mcmilnick/power_control/coffee_pot_app/pic/add_buttons.png

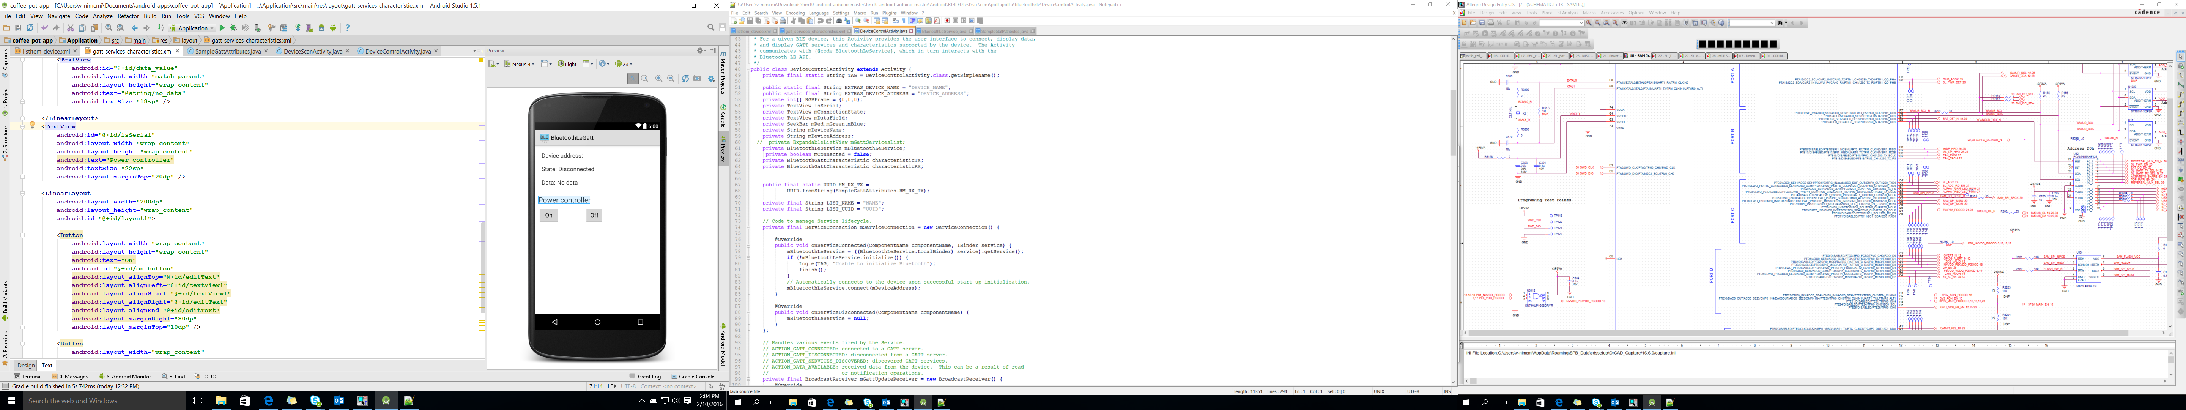
coffee_pot_app/pic/add_buttons.png
