mcmilnick/power_control/coffee_pot_app/pic/configure_attributes.png

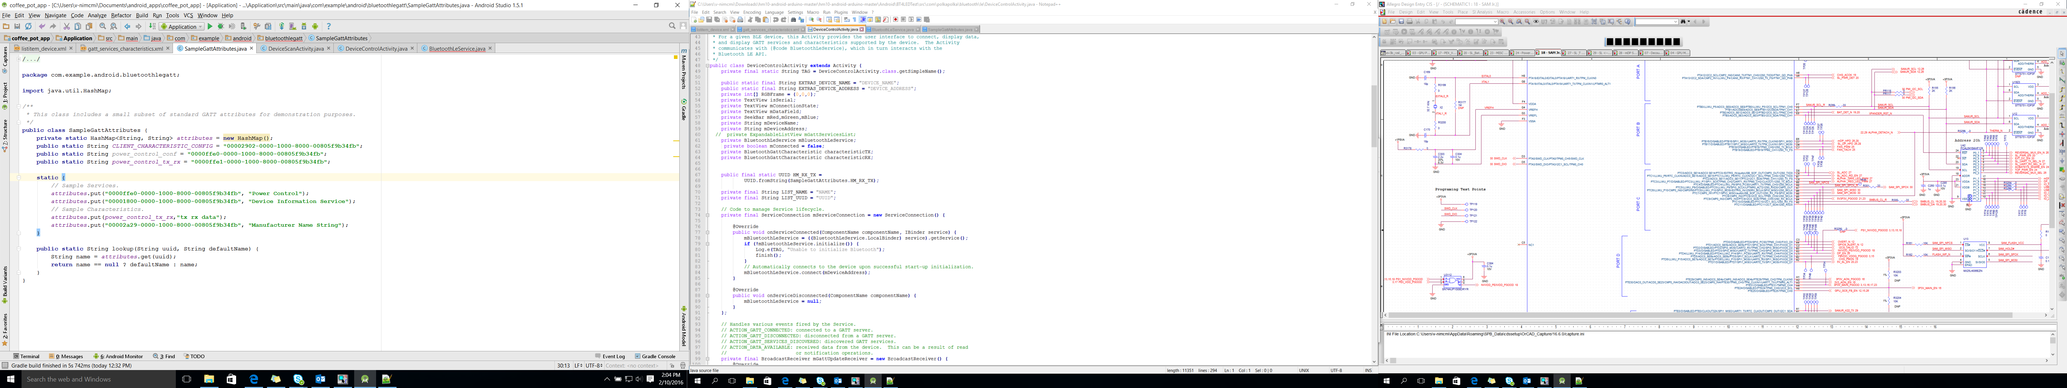
coffee_pot_app/pic/configure_attributes.png
