mcmilnick/power_control/coffee_pot_app/pic/edit layout.png

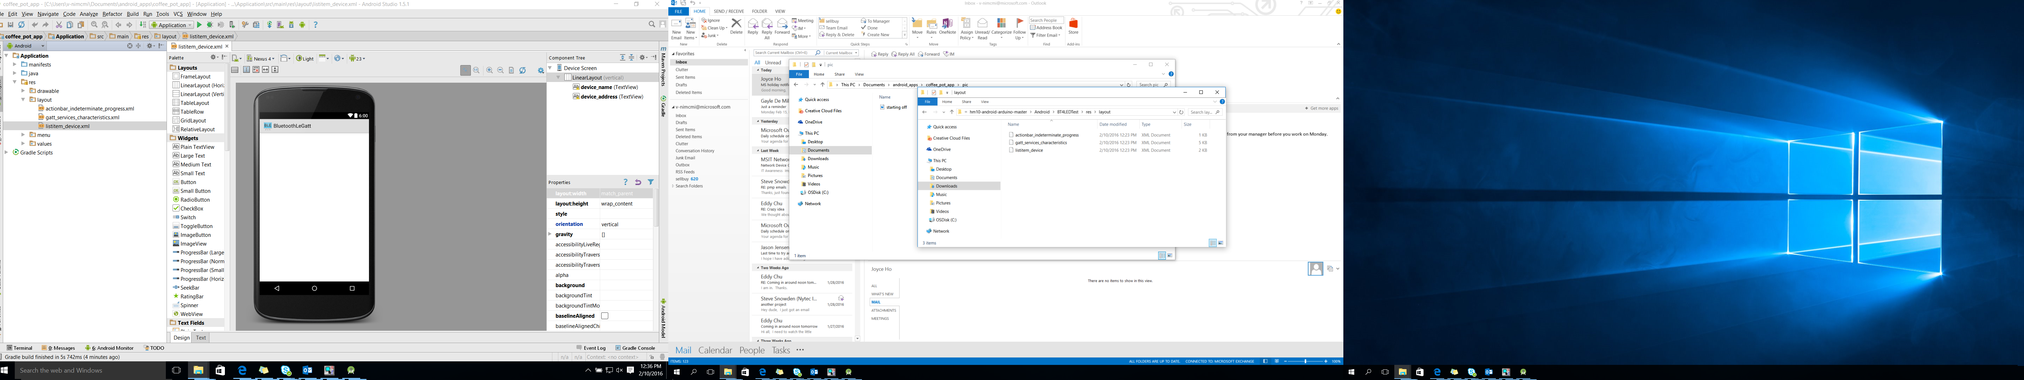
coffee_pot_app/pic/edit layout.png
