mcmilnick/power_control/coffee_pot_app/pic/read_and_write_commands.png

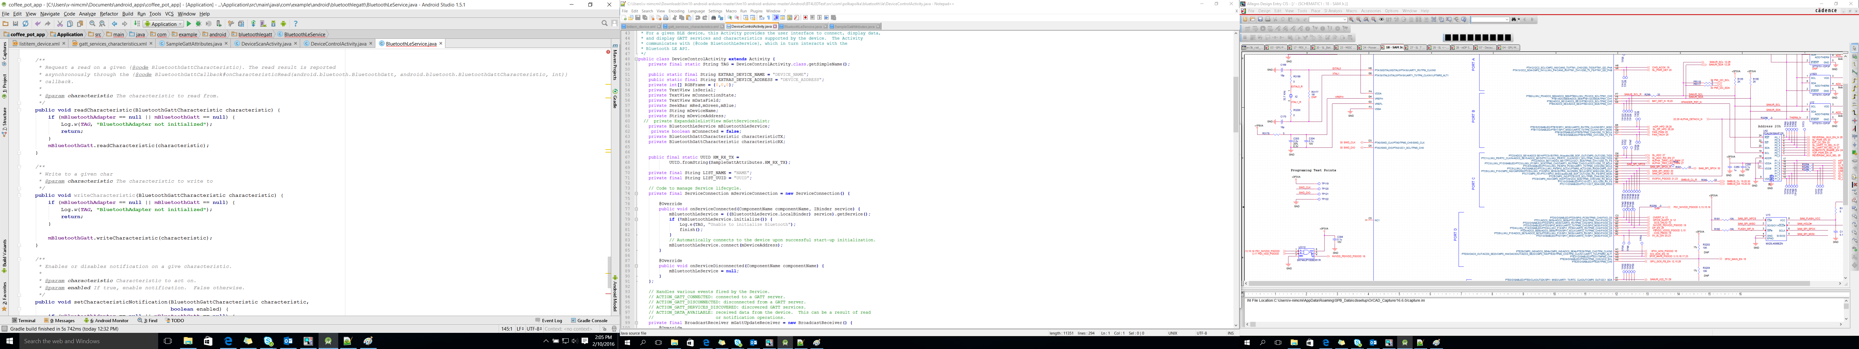
coffee_pot_app/pic/read_and_write_commands.png
