mcmilnick/power_control/coffee_pot_app/pic/starting off.png

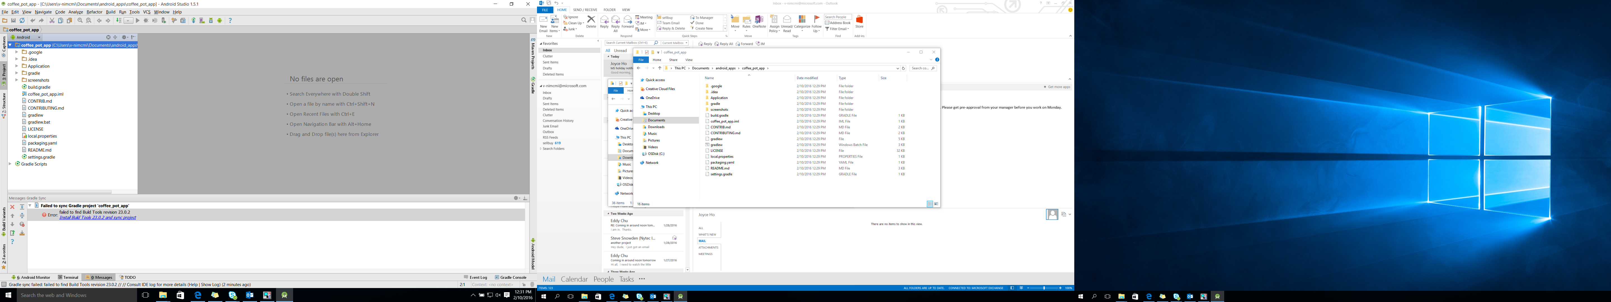
coffee_pot_app/pic/starting off.png
