mcmilnick/power_control/power_control_rev2_bom.xls

 |  |  | XPP Rev3 BOM
Part | Value | Quantity | Specs | Manufacturer# | Distributor# | Company | Notes
C3,5,6,7,17,18 | .1uF | 6 | 0.1UF 16V 10% X5R 0402 | GRM155R61C104KA88D | 490-5415-1-ND | Murata
C1,2,4,8,9,11,15,16 | 1.0uF | 8 | CAP CER 1UF 6.3V X5R 0402 | GRM155R60J105KE19D | 490-1320-1-ND | Murata
C13 | 0.2pF | 1 | CAP CER 0.2PF 50V NP0 0603 | CL10C0R2BB8NNNC | 1276-2144-1-ND | Samsung
C14 | 1.5pF | 1 | CAP CER 1.5PF 50V NP0 0603 | CL10C1R5BB8NNNC | 1276-1071-1-ND | Samsung
R1,2 | 560 | 2 | RES SMD 560 OHM 1% 1/10W 0603 | RC0603FR-07560RL | 311-560HRCT-ND | Yageo
R3 | 1.5k | 1 | RES 1.5K OHM 1/4W 5% CARBON FILM | CF14JT1K50 | CF14JT1K50CT-ND | Stackpole
D1 | 6.2V Zener | 1 | DIODE ZENER 6.2V 500MW DO35 | 1N821 | 1N821-1-ND | Microsemi
L1,2 | Fixed Inductor | 2 | .0018uH 5% .05ohm Unsheilded SMT | 1210-018J | 807-1210-018J | API | Change to 1210 next rev
U1 | Micro | 1 | PSOC BLE M0/Radio | CY8C4247LQI-BL473 | 428-3365-5-ND | Cypress
U2 | 24MHz crystal | 1 | Crystal 26.0000MHz 10ppm 6pF 80 Ohm | CX3225SB24000D0FFJCC | 1253-1352-1-ND | AVX
U3 | Programming header | 1 | 5pin JTAG Connector | TSW-105-07-T-S | SAM1035-05-ND | Samtec
U4 | Ceramic_Antenna | 1 | ANTENNA CHIP 2.4GHZ | 2450AT42B100E | 712-1008-1-ND | Johanson Tech
U5 | Red LED | 1 | LED 0402 RED 50MW 20MA SMD | SML-P11UTT86 | 511-1653-1-ND | Rohm
U6 | Green LED | 1 | LED 0402 GREEN 54MW 20MA SMD | SML-P11MTT86 | 511-1652-1-ND | Rohm
U7 | 5V Relay | 1 | SPDT 2A 5V Relay | G6E-134P-US DC5 | Z3668-ND | Omron
T1 | NPN Fet | 1 | TRANS NPN 30V 0.8A TO-18 | 2N2222 | 2N2222CS-ND | Central Semi
Con 1-6 | Test clips | 6 | Through hole hooks for testing | Keystone Electronics 5006 | 36-5006-ND | Keystone Electronics
