mcmilnick/power_control/mechanical/proto_coffee_box.stl

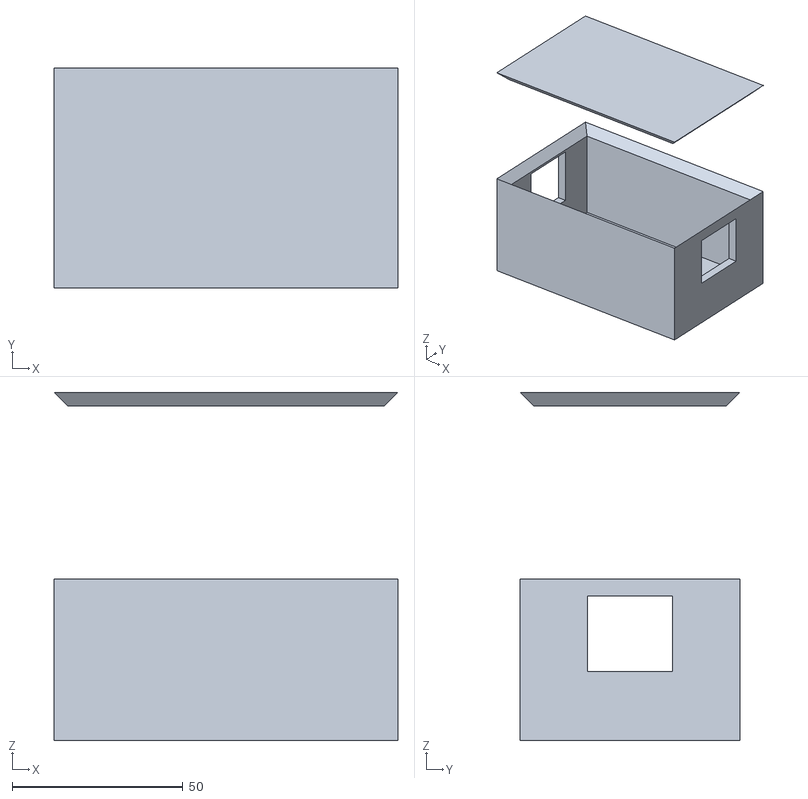
[picture p6: CAD file, 2016-02-23]
mechanical/proto_coffee_box.stl
100.7 x 64.3 x 102.0
