mcmilnick/power_control/(list of files, cad)

Other CAD files:
mechanical/general_box.blend
mechanical/proto_coffee_box.blend
