mcmilnick/power_control/power_control_rev2/power_control_rev2.brd

## EAGLE design power_control_rev2/power_control_rev2.brd (2016-03-08)

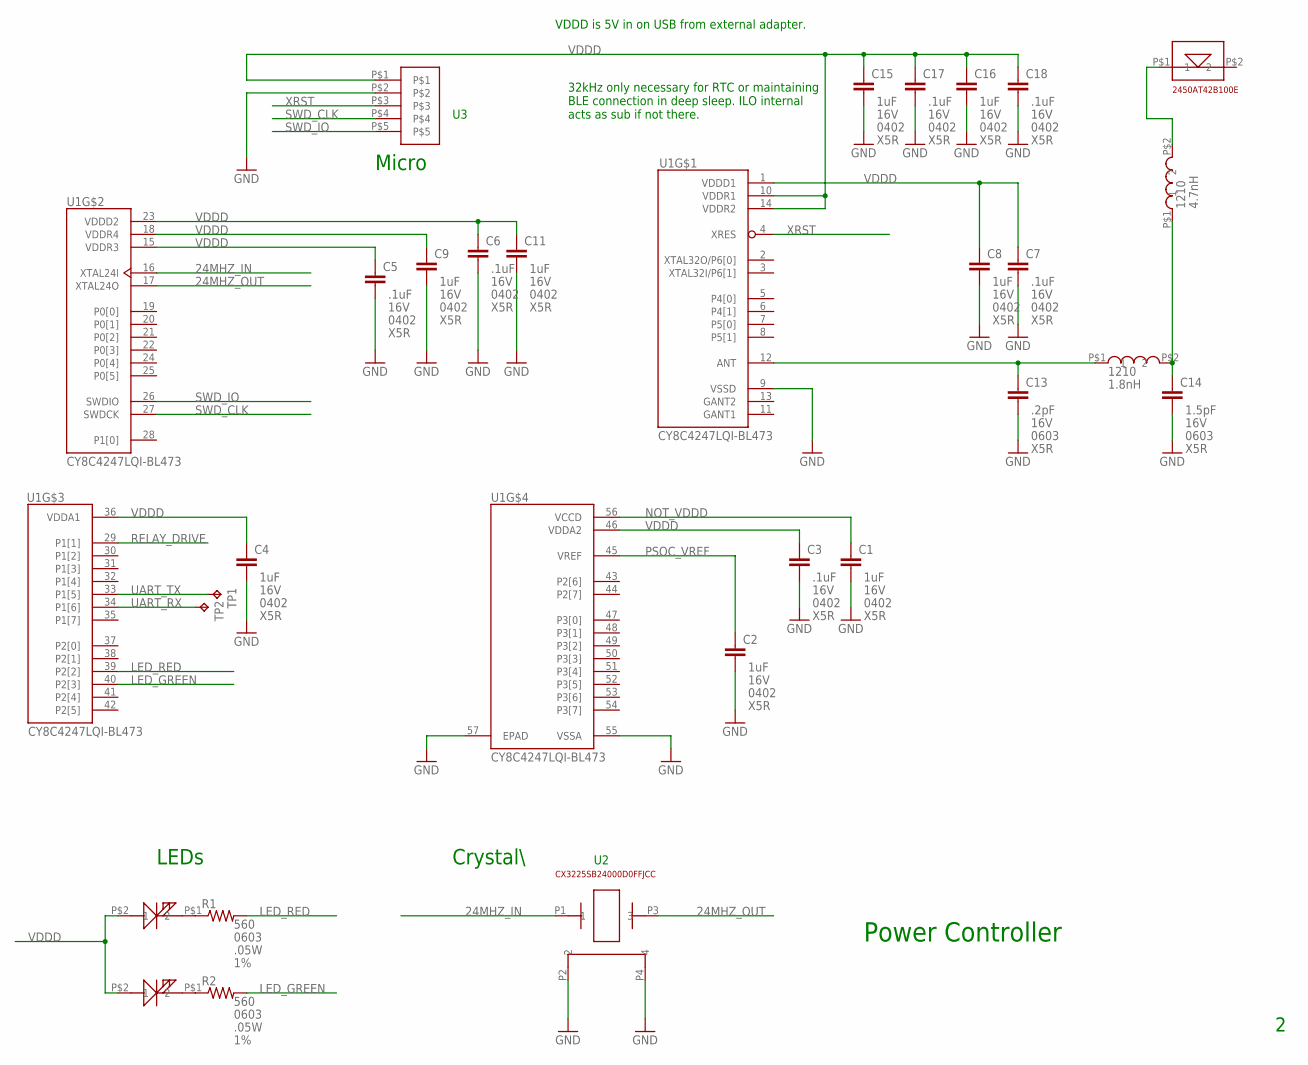
[picture p7: schematic power_control_rev2.sch, sheet 1]

Parts:
C1, C2, C3, C4, C5, C6, C7, C8, C9, C11, C15, C16, C17, C18: CC0402; C0402; RATING X5R; TOLERANCE 16V
C13, C14: CC0603; C0603
R1, R2: R-US_R0603; R0603; TOLERANCE 1%
TP1, TP2: TPB1,27; B1,27
U1: CY8C4247LQI-BL473; JEDEC_MO-248_QFN-56-7MMX7MM
U$1, U$8: 1210_INDUCTOR
U$2: CX3225SB24000D0FFJCC
U$3: SAMTEC1X5; 5XHEADER
U$4: 2450AT42B100E
U$5, U$6: SML-P11UTT86

Connections:
24MHZ_IN: U1.16 (XTAL24I), U$2.P1 (1)
24MHZ_OUT: U1.17 (XTAL24O), U$2.P3 (3)
GANT1: U1.11 (GANT1)
GANT2: U1.13 (GANT2)
GND: C1.2, C2.2, C3.2, C4.2, C5.2, C6.2, C7.2, C8.2, C9.2, C11.2, C13.2, C14.2, C15.2, C16.2, C17.2, C18.2, U1.9 (VSSD), U1.55 (VSSA), U1.57 (EPAD), U$2.P2 (2), U$2.P4 (4), U$3.P$2; also elsewhere on the board
LED_GREEN: R2.2, U1.40 (P2[3])
LED_RED: R1.2, U1.39 (P2[2])
unnamed: R2.1, U$6.P$1 (2)
unnamed: R1.1, U$5.P$1 (2)
unnamed: U$4.P$1 (1), U$8.P$2 (2)
unnamed: C13.1, U1.12 (ANT), U$1.P$1 (1)
unnamed: C14.1, U$1.P$2 (2), U$8.P$1 (1)
NOT_VDDD: C1.1, U1.56 (VCCD)
PSOC_VREF: C2.1, U1.45 (VREF)
RELAY_DRIVE: U1.29 (P1[1]); also elsewhere on the board
SWD_CLK: U1.27 (SWDCK), U$3.P$4
SWD_IO: U1.26 (SWDIO), U$3.P$5
UART_RX: TP2.TP, U1.34 (P1[6])
UART_TX: TP1.TP, U1.33 (P1[5])
VDDD: C3.1, C4.1, C5.1, C6.1, C7.1, C8.1, C9.1, C11.1, C15.1, C16.1, C17.1, C18.1, U1.1 (VDDD1), U1.10 (VDDR1), U1.14 (VDDR2), U1.15 (VDDR3), U1.18 (VDDR4), U1.23 (VDDD2), U1.36 (VDDA1), U1.46 (VDDA2), U$3.P$1, U$5.P$2 (1), U$6.P$2 (1); also elsewhere on the board
XRST: U1.4 (XRES), U$3.P$3

Notes on the sheet:
LEDs
Power Controller
Micro
32kHz only necessary for RTC or maintaining BLE connection in deep sleep. ILO internal acts as sub if not there.
Crystal\
VDDD is 5V in on USB from external adapter.

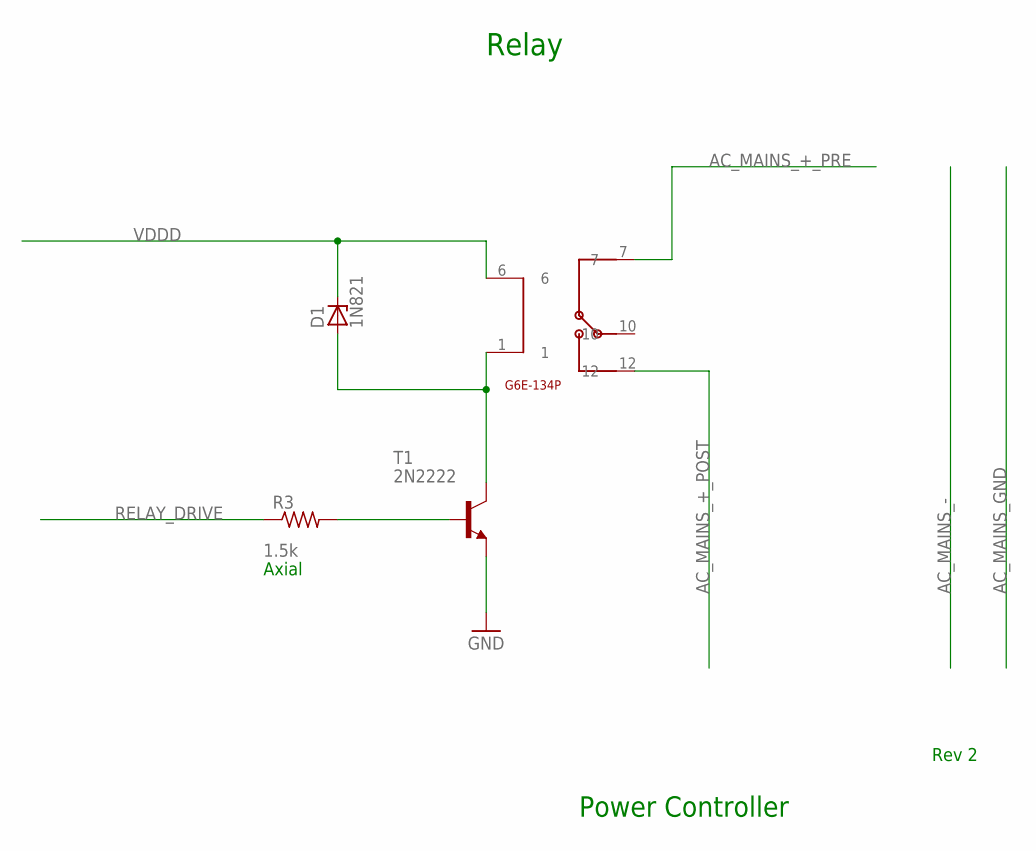
[picture p8: schematic power_control_rev2.sch, sheet 2]

Parts:
D1: 1N821; DO35Z10
R3: R-US_0204/2V; 0204V
T1: 2N2222; TO18
U$7: G6E-134P

Connections:
AC_MAINS_+_POST: U$7.12
AC_MAINS_+_PRE: U$7.7
GND: T1.1 (E); also elsewhere on the board
unnamed: D1.A, T1.3 (C), U$7.1
unnamed: R3.2, T1.2 (B)
RELAY_DRIVE: R3.1; also elsewhere on the board
VDDD: D1.C, U$7.6; also elsewhere on the board

Notes on the sheet:
Relay
Power Controller
Rev 2
Axial

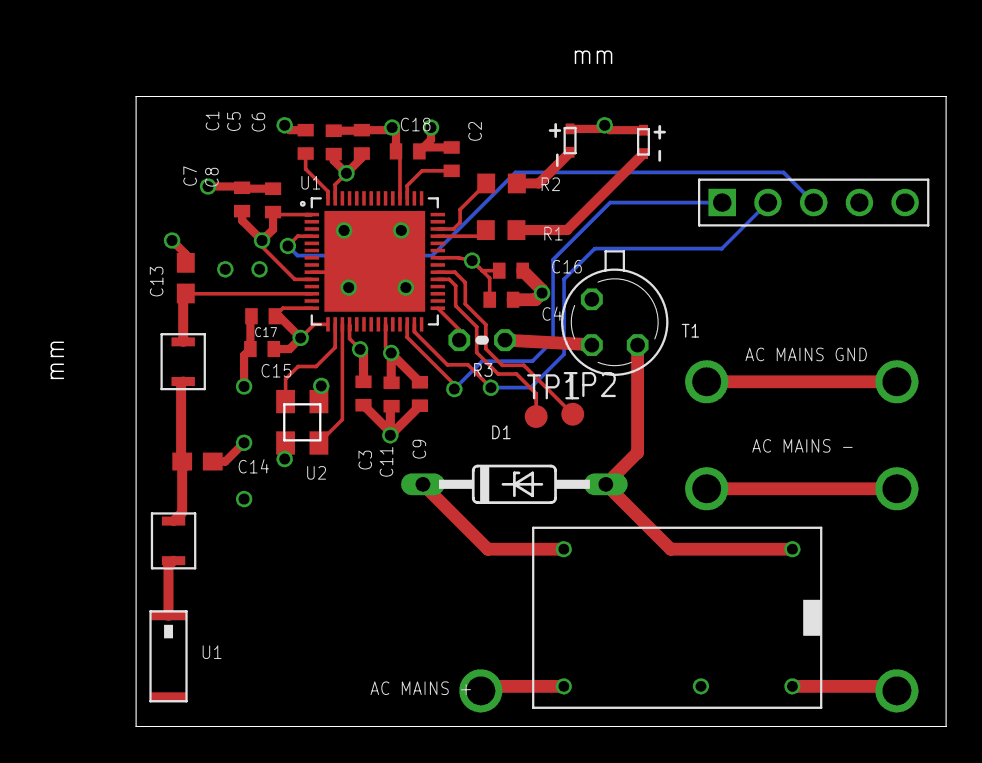
[picture p9: board power_control_rev2.brd from above]

Board: 4 copper layers, 45.0 x 35.0 mm, 32 parts (0 on the bottom side), 21 nets.
