mcmilnick/power_control/(commit log)

2016-02-23 Contains first and second rev of schematic, first run PCB, BOM, mechanical files for 3D printing and laser cutting, FW, and Android APP
    [coffee_pot_1.sch, general_box.blend, power_control_rev2.brd, power_control_rev2.sch, power_control_rev2_bom.xls, proto_coffee_box.blend, proto_coffee_box.stl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]
2016-03-08 Changed layout in rev2
    Changed pad sizes and added test points for UART.
    [power_control_rev2.brd, power_control_rev2.sch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]
